UCSBRoboticsClub/Teensy-Mouse-2015/README.md

# Teensy-Mouse-2015
Micromoue but even smaller. Using a Teensy and vl6180 sensors
