UCSBRoboticsClub/Teensy-Mouse-2015/CAD/Lego wheel to worm motor.SLDPRT

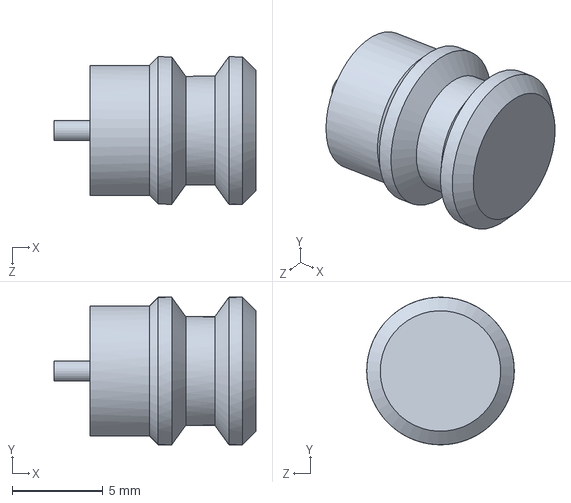
[picture p1: CAD file, 2015-04-18]
CAD/Lego wheel to worm motor.SLDPRT
11.1 x 8.15 x 8.15 mm
