UCSBRoboticsClub/Teensy-Mouse-2015/pcb/Teensy MouseV2.0_top_Deck.brd

## EAGLE design pcb/Teensy MouseV2.0_top_Deck.brd (2015-04-07)

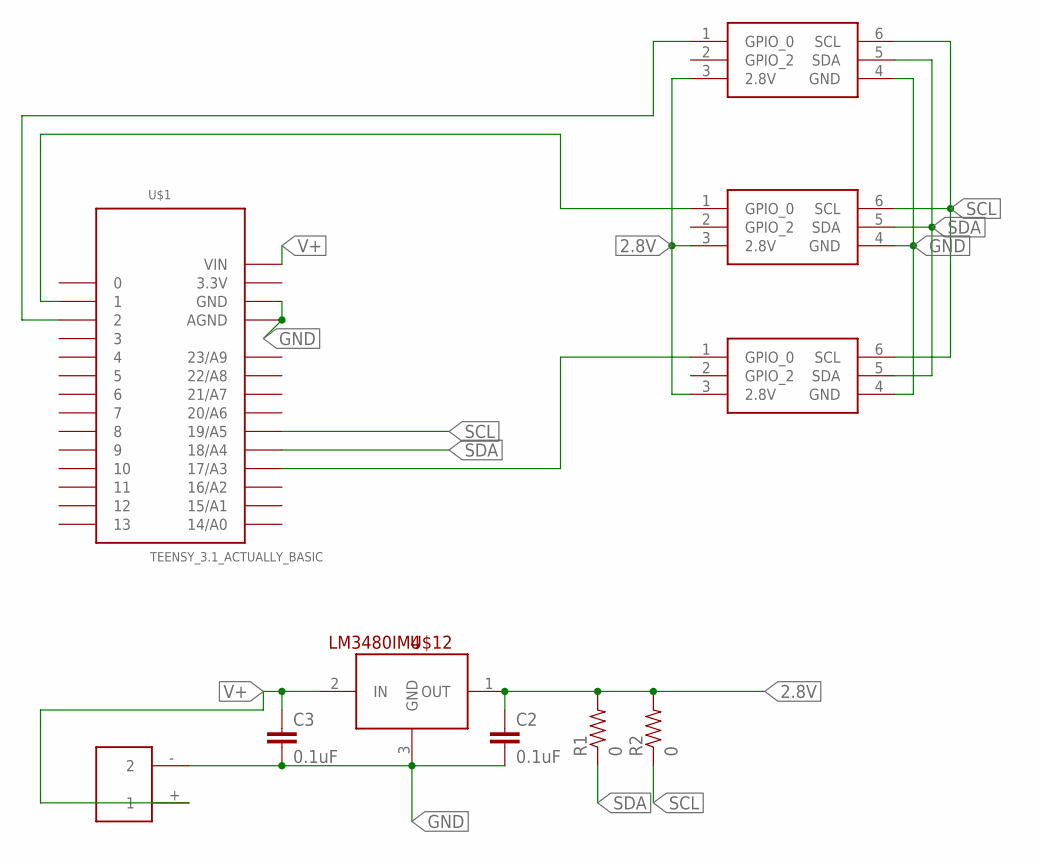
[picture p2: schematic Teensy MouseV2.0_top_Deck.sch]

Parts:
C2, C3: 0.1uF; 0603-CAP
R1, R2: 0; 0603
U$1: TEENSY_3.1_ACTUALLY_BASIC; TEENSY_3.0_ACTUALLY_BASIC
U$2: PICOBLADE2X
U$9, U$10, U$11: PATRICK'S_ST_SENSOR_BOARD; 2X3HEADER
U$12: LM3480IM4; SOT23-3

Connections:
2.8V: C2.1, R1.2, R2.2, U$9.3 (2.8V), U$10.3 (2.8V), U$11.3 (2.8V), U$12.1 (OUT)
3.3V: U$1.3.3V
GND: C2.2, C3.2, U$1.AGND, U$1.GND, U$2.- (2), U$9.4 (GND), U$10.4 (GND), U$11.4 (GND), U$12.3 (GND)
unnamed: U$1.17/A3, U$11.1 (GPIO_0)
unnamed: U$1.1, U$10.1 (GPIO_0)
unnamed: U$1.2, U$9.1 (GPIO_0)
SCL: R2.1, U$1.19/A5, U$9.6 (SCL), U$10.6 (SCL), U$11.6 (SCL)
SDA: R1.1, U$1.18/A4, U$9.5 (SDA), U$10.5 (SDA), U$11.5 (SDA)
V+: C3.1, U$1.VIN, U$2.+ (1), U$12.2 (IN)

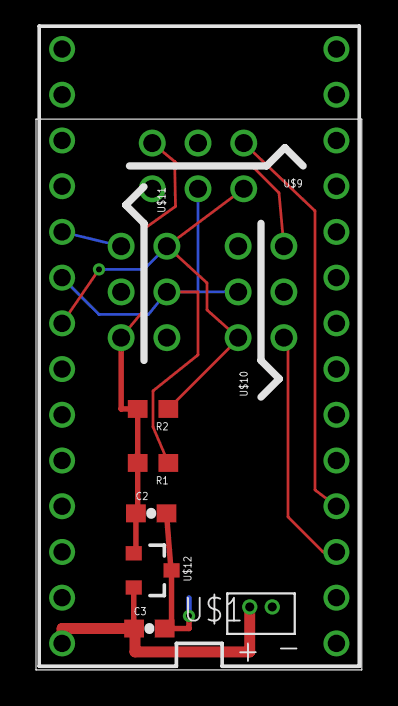
[picture p3: board Teensy MouseV2.0_top_Deck.brd from above]

Board: 2 copper layers, 18.1 x 30.6 mm, 10 parts (0 on the bottom side), 8 nets.
