UCSBRoboticsClub/Teensy-Mouse-2015/pcb/Teensy MouseV2.0_bottom_Deck.brd

## EAGLE design pcb/Teensy MouseV2.0_bottom_Deck.brd (2015-04-07)

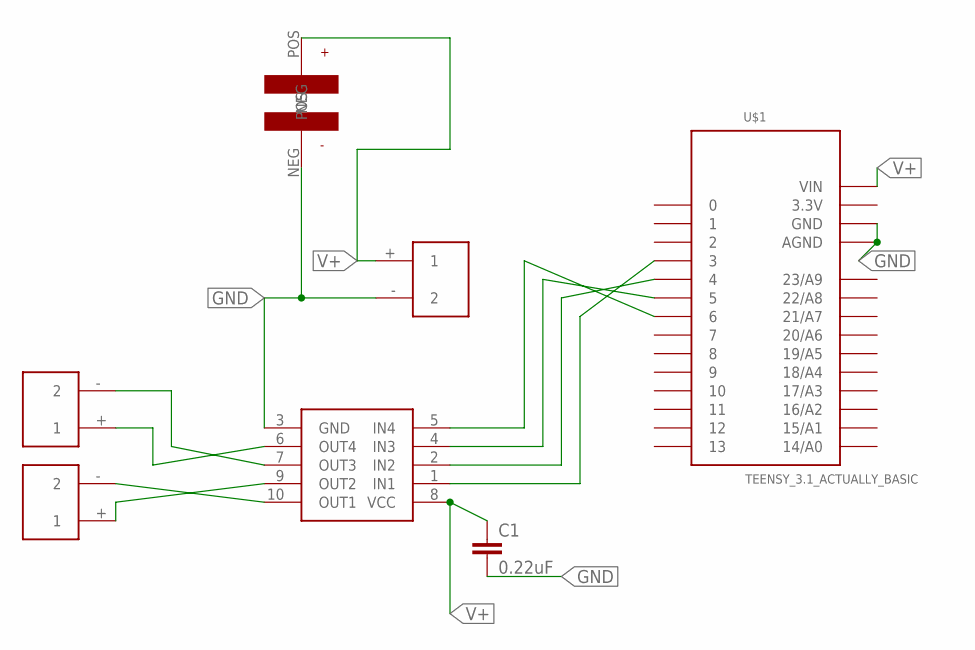
[picture p4: schematic Teensy MouseV2.0_bottom_Deck.sch]

Parts:
C1: 0.22uF; 0603-CAP
U$1: TEENSY_3.1_ACTUALLY_BASIC; TEENSY_3.0_ACTUALLY_BASIC
U$2, U$3: TEENSYMOUSEMOTORS; TEENSYMOUSEMOTRS
U$4: PICOBLADE2X
U$5: 47UFBUTTONCAP; ALUMINIUMELECTOCAP
U$7: A3901DUALHBRIDGE; 10WFDFN

Connections:
3.3V: U$1.3.3V
GND: C1.2, U$1.AGND, U$1.GND, U$4.- (2), U$5.NEG, U$7.3 (GND)
unnamed: U$3.- (2), U$7.7 (OUT3)
unnamed: U$3.+ (1), U$7.6 (OUT4)
unnamed: U$2.- (2), U$7.10 (OUT1)
unnamed: U$2.+ (1), U$7.9 (OUT2)
unnamed: U$1.6, U$7.5 (IN4)
unnamed: U$1.5, U$7.4 (IN3)
unnamed: U$1.4, U$7.2 (IN2)
unnamed: U$1.3, U$7.1 (IN1)
V+: C1.1, U$1.VIN, U$4.+ (1), U$5.POS, U$7.8 (VCC)

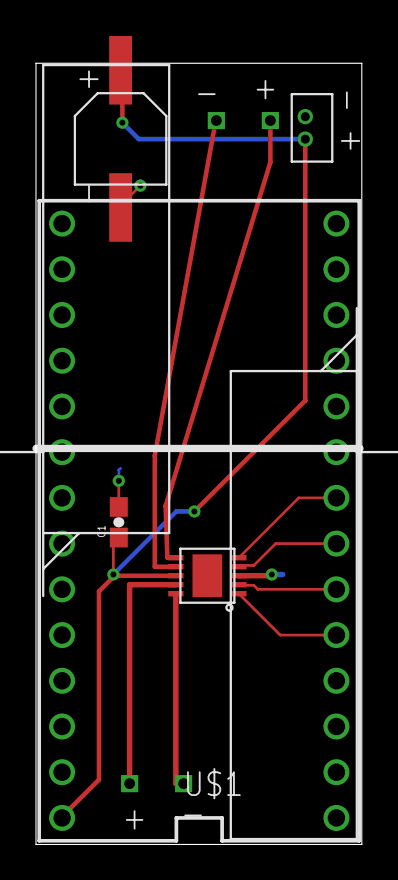
[picture p5: board Teensy MouseV2.0_bottom_Deck.brd from above]

Board: 2 copper layers, 18.1 x 43.4 mm, 7 parts (0 on the bottom side), 10 nets.
