UCSBRoboticsClub/Teensy-Mouse-2015/Teensymouse2015/drv8833.h

#ifndef DRV8833_H
#define DRV8833_H


class Motor
{
public:
    Motor(int pin1, int pin2);
    void write(float value);
    Motor& operator=(float value);
    void brake();
    
private:
    const int pin1;
    const int pin2;
};

#endif // DRV8833_H
