UCSBRoboticsClub/Teensy-Mouse-2015/(commit log)

2015-04-07 Added pcb designs
    [Teensy MouseV2.0.brd, Teensy MouseV2.0.sch, Teensy MouseV2.0_bottom_Deck.brd, Teensy MouseV2.0_bottom_Deck.sch, Teensy MouseV2.0_top_Deck.brd, Teensy MouseV2.0_top_Deck.sch]
2015-04-11 Added wheel bit for the Teensy Mouse
    Printing 2 would be good
    [Lego wheel to worm motor.SLDPRT]
2015-04-18 Changed chamfer angle
    [Lego wheel to worm motor.SLDPRT]
